dattasaurabh82/diy_fingerprint_based_unlocker/tiny_aes.h

// ============================================================
// tiny_aes.h — Minimal AES-256-CBC implementation
// self-contained, no external dependencies
//
// Based on FIPS 197 (AES specification).
// Provides ONLY what we need: AES-256-CBC encrypt/decrypt
// for 32-byte (2-block) buffers.
//
// Not general-purpose crypto — purpose-built for this project.
// ============================================================
#ifndef TINY_AES_H
#define TINY_AES_H

#include <stdint.h>
#include <string.h>

#define AES_BLOCKLEN  16
#define AES_KEYLEN    32   // AES-256
#define AES_ROUNDS    14   // AES-256 = 14 rounds
#define AES_KEYEXPSIZE 240 // 4 * (AES_ROUNDS + 1) * 4

// ─── Context ───
struct AesCtx {
  uint8_t roundKey[AES_KEYEXPSIZE];
  uint8_t iv[AES_BLOCKLEN];
};

// ─── S-box (SubBytes) ───
static const uint8_t _aes_sbox[256] = {
  0x63,0x7c,0x77,0x7b,0xf2,0x6b,0x6f,0xc5,0x30,0x01,0x67,0x2b,0xfe,0xd7,0xab,0x76,
  0xca,0x82,0xc9,0x7d,0xfa,0x59,0x47,0xf0,0xad,0xd4,0xa2,0xaf,0x9c,0xa4,0x72,0xc0,
  0xb7,0xfd,0x93,0x26,0x36,0x3f,0xf7,0xcc,0x34,0xa5,0xe5,0xf1,0x71,0xd8,0x31,0x15,
  0x04,0xc7,0x23,0xc3,0x18,0x96,0x05,0x9a,0x07,0x12,0x80,0xe2,0xeb,0x27,0xb2,0x75,
  0x09,0x83,0x2c,0x1a,0x1b,0x6e,0x5a,0xa0,0x52,0x3b,0xd6,0xb3,0x29,0xe3,0x2f,0x84,
  0x53,0xd1,0x00,0xed,0x20,0xfc,0xb1,0x5b,0x6a,0xcb,0xbe,0x39,0x4a,0x4c,0x58,0xcf,
  0xd0,0xef,0xaa,0xfb,0x43,0x4d,0x33,0x85,0x45,0xf9,0x02,0x7f,0x50,0x3c,0x9f,0xa8,
  0x51,0xa3,0x40,0x8f,0x92,0x9d,0x38,0xf5,0xbc,0xb6,0xda,0x21,0x10,0xff,0xf3,0xd2,
  0xcd,0x0c,0x13,0xec,0x5f,0x97,0x44,0x17,0xc4,0xa7,0x7e,0x3d,0x64,0x5d,0x19,0x73,
  0x60,0x81,0x4f,0xdc,0x22,0x2a,0x90,0x88,0x46,0xee,0xb8,0x14,0xde,0x5e,0x0b,0xdb,
  0xe0,0x32,0x3a,0x0a,0x49,0x06,0x24,0x5c,0xc2,0xd3,0xac,0x62,0x91,0x95,0xe4,0x79,
  0xe7,0xc8,0x37,0x6d,0x8d,0xd5,0x4e,0xa9,0x6c,0x56,0xf4,0xea,0x65,0x7a,0xae,0x08,
  0xba,0x78,0x25,0x2e,0x1c,0xa6,0xb4,0xc6,0xe8,0xdd,0x74,0x1f,0x4b,0xbd,0x8b,0x8a,
  0x70,0x3e,0xb5,0x66,0x48,0x03,0xf6,0x0e,0x61,0x35,0x57,0xb9,0x86,0xc1,0x1d,0x9e,
  0xe1,0xf8,0x98,0x11,0x69,0xd9,0x8e,0x94,0x9b,0x1e,0x87,0xe9,0xce,0x55,0x28,0xdf,
  0x8c,0xa1,0x89,0x0d,0xbf,0xe6,0x42,0x68,0x41,0x99,0x2d,0x0f,0xb0,0x54,0xbb,0x16
};

// ─── Inverse S-box (InvSubBytes) ───
static const uint8_t _aes_rsbox[256] = {
  0x52,0x09,0x6a,0xd5,0x30,0x36,0xa5,0x38,0xbf,0x40,0xa3,0x9e,0x81,0xf3,0xd7,0xfb,
  0x7c,0xe3,0x39,0x82,0x9b,0x2f,0xff,0x87,0x34,0x8e,0x43,0x44,0xc4,0xde,0xe9,0xcb,
  0x54,0x7b,0x94,0x32,0xa6,0xc2,0x23,0x3d,0xee,0x4c,0x95,0x0b,0x42,0xfa,0xc3,0x4e,
  0x08,0x2e,0xa1,0x66,0x28,0xd9,0x24,0xb2,0x76,0x5b,0xa2,0x49,0x6d,0x8b,0xd1,0x25,
  0x72,0xf8,0xf6,0x64,0x86,0x68,0x98,0x16,0xd4,0xa4,0x5c,0xcc,0x5d,0x65,0xb6,0x92,
  0x6c,0x70,0x48,0x50,0xfd,0xed,0xb9,0xda,0x5e,0x15,0x46,0x57,0xa7,0x8d,0x9d,0x84,
  0x90,0xd8,0xab,0x00,0x8c,0xbc,0xd3,0x0a,0xf7,0xe4,0x58,0x05,0xb8,0xb3,0x45,0x06,
  0xd0,0x2c,0x1e,0x8f,0xca,0x3f,0x0f,0x02,0xc1,0xaf,0xbd,0x03,0x01,0x13,0x8a,0x6b,
  0x3a,0x91,0x11,0x41,0x4f,0x67,0xdc,0xea,0x97,0xf2,0xcf,0xce,0xf0,0xb4,0xe6,0x73,
  0x96,0xac,0x74,0x22,0xe7,0xad,0x35,0x85,0xe2,0xf9,0x37,0xe8,0x1c,0x75,0xdf,0x6e,
  0x47,0xf1,0x1a,0x71,0x1d,0x29,0xc5,0x89,0x6f,0xb7,0x62,0x0e,0xaa,0x18,0xbe,0x1b,
  0xfc,0x56,0x3e,0x4b,0xc6,0xd2,0x79,0x20,0x9a,0xdb,0xc0,0xfe,0x78,0xcd,0x5a,0xf4,
  0x1f,0xdd,0xa8,0x33,0x88,0x07,0xc7,0x31,0xb1,0x12,0x10,0x59,0x27,0x80,0xec,0x5f,
  0x60,0x51,0x7f,0xa9,0x19,0xb5,0x4a,0x0d,0x2d,0xe5,0x7a,0x9f,0x93,0xc9,0x9c,0xef,
  0xa0,0xe0,0x3b,0x4d,0xae,0x2a,0xf5,0xb0,0xc8,0xeb,0xbb,0x3c,0x83,0x53,0x99,0x61,
  0x17,0x2b,0x04,0x7e,0xba,0x77,0xd6,0x26,0xe1,0x69,0x14,0x63,0x55,0x21,0x0c,0x7d
};

// ─── Rcon ───
static const uint8_t _aes_rcon[11] = {
  0x8d, 0x01, 0x02, 0x04, 0x08, 0x10, 0x20, 0x40, 0x80, 0x1b, 0x36
};

// ─── GF(2^8) multiply helpers for MixColumns ───
static inline uint8_t _aes_xtime(uint8_t x) {
  return ((x << 1) ^ (((x >> 7) & 1) * 0x1b));
}

static inline uint8_t _aes_mul(uint8_t x, uint8_t y) {
  return (((y     & 1) * x) ^
          ((y >> 1 & 1) * _aes_xtime(x)) ^
          ((y >> 2 & 1) * _aes_xtime(_aes_xtime(x))) ^
          ((y >> 3 & 1) * _aes_xtime(_aes_xtime(_aes_xtime(x)))));
}

// ─── Key expansion for AES-256 ───
static inline void _aesKeyExpansion(AesCtx* ctx, const uint8_t* key) {
  uint8_t tempa[4];
  uint8_t* rk = ctx->roundKey;
  unsigned i, j, k;

  // First 8 words are the key itself
  for (i = 0; i < 8; i++) {
    rk[i * 4 + 0] = key[i * 4 + 0];
    rk[i * 4 + 1] = key[i * 4 + 1];
    rk[i * 4 + 2] = key[i * 4 + 2];
    rk[i * 4 + 3] = key[i * 4 + 3];
  }

  // Expand to 60 words
  for (i = 8; i < 4 * (AES_ROUNDS + 1); i++) {
    k = (i - 1) * 4;
    tempa[0] = rk[k + 0];
    tempa[1] = rk[k + 1];
    tempa[2] = rk[k + 2];
    tempa[3] = rk[k + 3];

    if (i % 8 == 0) {
      // RotWord + SubWord + Rcon
      uint8_t u8tmp = tempa[0];
      tempa[0] = _aes_sbox[tempa[1]] ^ _aes_rcon[i / 8];
      tempa[1] = _aes_sbox[tempa[2]];
      tempa[2] = _aes_sbox[tempa[3]];
      tempa[3] = _aes_sbox[u8tmp];
    } else if (i % 8 == 4) {
      // SubWord only (AES-256 extra step)
      tempa[0] = _aes_sbox[tempa[0]];
      tempa[1] = _aes_sbox[tempa[1]];
      tempa[2] = _aes_sbox[tempa[2]];
      tempa[3] = _aes_sbox[tempa[3]];
    }

    j = i * 4;
    k = (i - 8) * 4;
    rk[j + 0] = rk[k + 0] ^ tempa[0];
    rk[j + 1] = rk[k + 1] ^ tempa[1];
    rk[j + 2] = rk[k + 2] ^ tempa[2];
    rk[j + 3] = rk[k + 3] ^ tempa[3];
  }
}

// ─── AddRoundKey ───
static inline void _aesAddRoundKey(uint8_t round, uint8_t state[4][4], const uint8_t* rk) {
  for (uint8_t i = 0; i < 4; i++) {
    for (uint8_t j = 0; j < 4; j++) {
      state[i][j] ^= rk[(round * 16) + (i * 4) + j];
    }
  }
}

// ─── SubBytes ───
static inline void _aesSubBytes(uint8_t state[4][4]) {
  for (uint8_t i = 0; i < 4; i++)
    for (uint8_t j = 0; j < 4; j++)
      state[i][j] = _aes_sbox[state[i][j]];
}

// ─── ShiftRows ───
static inline void _aesShiftRows(uint8_t state[4][4]) {
  uint8_t temp;
  // Row 1: shift left 1
  temp = state[0][1]; state[0][1] = state[1][1]; state[1][1] = state[2][1]; state[2][1] = state[3][1]; state[3][1] = temp;
  // Row 2: shift left 2
  temp = state[0][2]; state[0][2] = state[2][2]; state[2][2] = temp;
  temp = state[1][2]; state[1][2] = state[3][2]; state[3][2] = temp;
  // Row 3: shift left 3
  temp = state[0][3]; state[0][3] = state[3][3]; state[3][3] = state[2][3]; state[2][3] = state[1][3]; state[1][3] = temp;
}

// ─── MixColumns ───
static inline void _aesMixColumns(uint8_t state[4][4]) {
  for (uint8_t i = 0; i < 4; i++) {
    uint8_t a = state[i][0], b = state[i][1], c = state[i][2], d = state[i][3];
    uint8_t e = a ^ b ^ c ^ d;
    state[i][0] ^= e ^ _aes_xtime(a ^ b);
    state[i][1] ^= e ^ _aes_xtime(b ^ c);
    state[i][2] ^= e ^ _aes_xtime(c ^ d);
    state[i][3] ^= e ^ _aes_xtime(d ^ a);
  }
}

// ─── InvSubBytes ───
static inline void _aesInvSubBytes(uint8_t state[4][4]) {
  for (uint8_t i = 0; i < 4; i++)
    for (uint8_t j = 0; j < 4; j++)
      state[i][j] = _aes_rsbox[state[i][j]];
}

// ─── InvShiftRows ───
static inline void _aesInvShiftRows(uint8_t state[4][4]) {
  uint8_t temp;
  // Row 1: shift right 1
  temp = state[3][1]; state[3][1] = state[2][1]; state[2][1] = state[1][1]; state[1][1] = state[0][1]; state[0][1] = temp;
  // Row 2: shift right 2
  temp = state[0][2]; state[0][2] = state[2][2]; state[2][2] = temp;
  temp = state[1][2]; state[1][2] = state[3][2]; state[3][2] = temp;
  // Row 3: shift right 3
  temp = state[3][3]; state[3][3] = state[0][3]; state[0][3] = state[1][3]; state[1][3] = state[2][3]; state[2][3] = temp;
}

// ─── InvMixColumns ───
static inline void _aesInvMixColumns(uint8_t state[4][4]) {
  for (uint8_t i = 0; i < 4; i++) {
    uint8_t a = state[i][0], b = state[i][1], c = state[i][2], d = state[i][3];
    state[i][0] = _aes_mul(a, 0x0e) ^ _aes_mul(b, 0x0b) ^ _aes_mul(c, 0x0d) ^ _aes_mul(d, 0x09);
    state[i][1] = _aes_mul(a, 0x09) ^ _aes_mul(b, 0x0e) ^ _aes_mul(c, 0x0b) ^ _aes_mul(d, 0x0d);
    state[i][2] = _aes_mul(a, 0x0d) ^ _aes_mul(b, 0x09) ^ _aes_mul(c, 0x0e) ^ _aes_mul(d, 0x0b);
    state[i][3] = _aes_mul(a, 0x0b) ^ _aes_mul(b, 0x0d) ^ _aes_mul(c, 0x09) ^ _aes_mul(d, 0x0e);
  }
}

// ─── Encrypt a single 16-byte block ───
static inline void _aesEncryptBlock(AesCtx* ctx, uint8_t* buf) {
  uint8_t state[4][4];

  // Copy input into state (column-major)
  for (uint8_t i = 0; i < 4; i++)
    for (uint8_t j = 0; j < 4; j++)
      state[i][j] = buf[i * 4 + j];

  _aesAddRoundKey(0, state, ctx->roundKey);

  for (uint8_t round = 1; round < AES_ROUNDS; round++) {
    _aesSubBytes(state);
    _aesShiftRows(state);
    _aesMixColumns(state);
    _aesAddRoundKey(round, state, ctx->roundKey);
  }

  // Final round (no MixColumns)
  _aesSubBytes(state);
  _aesShiftRows(state);
  _aesAddRoundKey(AES_ROUNDS, state, ctx->roundKey);

  // Copy state back to buffer
  for (uint8_t i = 0; i < 4; i++)
    for (uint8_t j = 0; j < 4; j++)
      buf[i * 4 + j] = state[i][j];
}

// ─── Decrypt a single 16-byte block ───
static inline void _aesDecryptBlock(AesCtx* ctx, uint8_t* buf) {
  uint8_t state[4][4];

  for (uint8_t i = 0; i < 4; i++)
    for (uint8_t j = 0; j < 4; j++)
      state[i][j] = buf[i * 4 + j];

  _aesAddRoundKey(AES_ROUNDS, state, ctx->roundKey);

  for (uint8_t round = AES_ROUNDS - 1; round > 0; round--) {
    _aesInvShiftRows(state);
    _aesInvSubBytes(state);
    _aesAddRoundKey(round, state, ctx->roundKey);
    _aesInvMixColumns(state);
  }

  // Final round (no InvMixColumns)
  _aesInvShiftRows(state);
  _aesInvSubBytes(state);
  _aesAddRoundKey(0, state, ctx->roundKey);

  for (uint8_t i = 0; i < 4; i++)
    for (uint8_t j = 0; j < 4; j++)
      buf[i * 4 + j] = state[i][j];
}

// ─── XOR block helper ───
static inline void _aesXorBlock(uint8_t* buf, const uint8_t* xor_with) {
  for (uint8_t i = 0; i < AES_BLOCKLEN; i++) {
    buf[i] ^= xor_with[i];
  }
}

// ============================================================
// PUBLIC API
// ============================================================

// Init context with 32-byte key and 16-byte IV
static inline void aesInitCtx(AesCtx* ctx, const uint8_t* key, const uint8_t* iv) {
  _aesKeyExpansion(ctx, key);
  memcpy(ctx->iv, iv, AES_BLOCKLEN);
}

// CBC encrypt buffer in-place. len must be multiple of 16.
static inline void aesCbcEncrypt(AesCtx* ctx, uint8_t* buf, uint32_t len) {
  uint8_t* iv = ctx->iv;
  for (uint32_t i = 0; i < len; i += AES_BLOCKLEN) {
    _aesXorBlock(buf + i, iv);
    _aesEncryptBlock(ctx, buf + i);
    iv = buf + i;  // ciphertext of this block is IV for next
  }
  // Save last ciphertext as new IV
  memcpy(ctx->iv, iv, AES_BLOCKLEN);
}

// CBC decrypt buffer in-place. len must be multiple of 16.
static inline void aesCbcDecrypt(AesCtx* ctx, uint8_t* buf, uint32_t len) {
  uint8_t nextIv[AES_BLOCKLEN];
  for (uint32_t i = 0; i < len; i += AES_BLOCKLEN) {
    memcpy(nextIv, buf + i, AES_BLOCKLEN);   // save ciphertext before decrypt
    _aesDecryptBlock(ctx, buf + i);
    _aesXorBlock(buf + i, ctx->iv);           // XOR with previous IV
    memcpy(ctx->iv, nextIv, AES_BLOCKLEN);    // update IV
  }
}

#endif // TINY_AES_H
