dattasaurabh82/diy_fingerprint_based_unlocker/(commit log)

2026-02-28 Milestone 1 — Boot + Switch + LED
2026-02-28 Milestone 2 — PASSED - `detectFinger()` returns 1 when finger present, 0 when not - `collectionFingerprint(timeout)` returns ERR_ID809 on failure (brief touches cause this — normal) - `search()` retu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
    [diy_fingerprint_based_unlocker.ino]
2026-02-28 Milestone 3 — Registration flow (two-slot safe) working
2026-02-28 Test 8 — HID Modifier Keys — PASSED
2026-02-28 ### Milestone 4 — Recognition flow + HID
2026-02-28 Un-track PLAN.md and keep it local
2026-02-28 Milestone 5 — Boot validation + atomic safety
2026-02-28 Milestone 6 — IRQ + Encrypted EEPROM — PASSED
2026-02-28 Updated ToDo and Roadmap (incl image to be filled and 3D enclosure info)
