dattasaurabh82/diy_fingerprint_based_unlocker/(notices)

Notices in the files:
README.md:
License: MIT
